meyer28j/level-detector/src/Core/Src/main.c

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
/* Includes ------------------------------------------------------------------*/
#include "main.h"
#include "cmsis_os.h"

I2C_HandleTypeDef hi2c1;

TIM_HandleTypeDef htim3;
DMA_HandleTypeDef hdma_tim3_ch1_trig;

UART_HandleTypeDef huart2;

/* Definitions for Init */
osThreadId_t InitHandle;
const osThreadAttr_t Init_attributes = {
  .name = "Init",
  .stack_size = 512 * 4,
  .priority = (osPriority_t) osPriorityHigh,
};
/* Definitions for LEDUpdate */
osThreadId_t LEDUpdateHandle;
const osThreadAttr_t LEDUpdate_attributes = {
  .name = "LEDUpdate",
  .stack_size = 512 * 4,
  .priority = (osPriority_t) osPriorityAboveNormal,
};
/* USER CODE BEGIN PV */

uint8_t RXChar; // input character from HAL_UART
HAL_StatusTypeDef status; // HAL_OK, HAL_ERROR, HAL_BUSY, HAL_TIMEOUT

/* USER CODE END PV */

void SystemClock_Config(void);
static void MX_GPIO_Init(void);
static void MX_DMA_Init(void);
static void MX_USART2_UART_Init(void);
static void MX_I2C1_Init(void);
static void MX_TIM3_Init(void);
void StartInit(void *argument);
void StartLEDUpdate(void *argument);

/* USER CODE BEGIN 0 */

/**
  * @brief process a receiving character from USART
  *        The goal is to keep the function as fast as possible
  *        and to delegate the slow tasks like transmission
  *        to the main to increase the availability of the
  *        function to serve the next interrupt
  * @param huart:  handler to USART2 ( the only used one - no need to check)
  * @retval None
  */
void HAL_UART_RxCpltCallback(UART_HandleTypeDef *huart)
{
        // process input string
        HandleInput(huart, RXChar);

        // wait until status is ok
        while((HAL_UART_GetState(huart)&HAL_UART_STATE_BUSY_RX)
                        == HAL_UART_STATE_BUSY_RX);
        //Listen for the interrupt and buffer one character at a time.
        status = HAL_UART_Receive_IT(huart, &RXChar, 1);
        if (status != HAL_OK)
        {
                Error_Handler();
        }

        return;
}

void HAL_GPIO_EXTI_Callback(uint16_t GPIO_Pin)
{
	return;
	/*
	if (GPIO_Pin == GPIO_PIN_9)
	{
    	BaseType_t xHigherPriorityTaskWoken = pdFALSE;
    	vTaskNotifyGiveFromISR(IMUDataFetchHandle, &xHigherPriorityTaskWoken);
    	portYIELD_FROM_ISR(xHigherPriorityTaskWoken);
	}
	*/
}

/* USER CODE END 0 */

/**
  * @brief  The application entry point.
  * @retval int
  */
int main(void)
{

  /* MCU Configuration--------------------------------------------------------*/

  /* Reset of all peripherals, Initializes the Flash interface and the Systick. */
  HAL_Init();

  /* Configure the system clock */
  SystemClock_Config();

  /* Initialize all configured peripherals */
  MX_GPIO_Init();
  MX_DMA_Init();
  MX_USART2_UART_Init();
  MX_I2C1_Init();
  MX_TIM3_Init();
  /* Init scheduler */
  osKernelInitialize();

  /* USER CODE BEGIN RTOS_MUTEX */
  /* add mutexes, ... */
  /* USER CODE END RTOS_MUTEX */

  /* USER CODE BEGIN RTOS_SEMAPHORES */
  /* add semaphores, ... */
  /* USER CODE END RTOS_SEMAPHORES */

  /* USER CODE BEGIN RTOS_TIMERS */
  /* start timers, add new ones, ... */
  /* USER CODE END RTOS_TIMERS */

  /* USER CODE BEGIN RTOS_QUEUES */
  /* add queues, ... */
  /* USER CODE END RTOS_QUEUES */

  /* Create the thread(s) */
  /* creation of Init */
  InitHandle = osThreadNew(StartInit, NULL, &Init_attributes);

  /* creation of LEDUpdate */
  LEDUpdateHandle = osThreadNew(StartLEDUpdate, NULL, &LEDUpdate_attributes);

  /* USER CODE BEGIN RTOS_THREADS */
  /* add threads, ... */
  /* USER CODE END RTOS_THREADS */

  /* USER CODE BEGIN RTOS_EVENTS */
  /* add events, ... */
  /* USER CODE END RTOS_EVENTS */

  /* Start scheduler */
  osKernelStart();

  /* We should never get here as control is now taken by the scheduler */

  /* Infinite loop */
  /* USER CODE BEGIN WHILE */
  while (1)
  {
    /* USER CODE END WHILE */

    /* USER CODE BEGIN 3 */
  }
  /* USER CODE END 3 */
}

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
/* USER CODE BEGIN Header_StartInit */
/**
* @brief Function implementing the Init thread.
* @param argument: Not used
* @retval None
*/
/* USER CODE END Header_StartInit */
void StartInit(void *argument)
{
  /* USER CODE BEGIN 5 */

	while (accel_init() != HAL_OK) {} // configure I2C LSM303DLHC peripheral

	CLIInit(&huart2); // initialize CLI
	HAL_UART_Receive_IT(&huart2, &RXChar, 1); // start receiving CLI input
	WS2812B_init(); // start data flow to LED matrix

	// set all LEDs to blue as indicator for init complete
	// should be immediately overwritten once IMU data is read and written to LEDs
	for (int i = 0; i < NUM_LEDS; i++)
	{
	  WS2812B_set_pixel_color(i, 0, 0, 8);
	}
	WS2812B_update();

	// suspend task after executing
	vTaskSuspend(NULL);

  /* USER CODE END 5 */
}

/* USER CODE BEGIN Header_StartLEDUpdate */
/**
* @brief Function implementing the LEDUpdate thread.
* @param argument: Not used
* @retval None
*/
/* USER CODE END Header_StartLEDUpdate */
void StartLEDUpdate(void *argument)
{
  /* USER CODE BEGIN StartLEDUpdate */

  const TickType_t xFrequency = pdMS_TO_TICKS(300);
  TickType_t xLastWakeTime;

  xLastWakeTime = xTaskGetTickCount();

  /* Infinite loop */
  for(;;)
  	{
	  vTaskDelayUntil(&xLastWakeTime, xFrequency);

	  // fetch accelerometer data
	  AccelData accel_values = read_accelerometer_data();

	  // handle console refresh
	  RefreshStatus(&huart2, accel_values);

	  // update led dispay
	  WS2812B_point(accel_values);
	  WS2812B_update();
	}
  /* USER CODE END StartLEDUpdate */
}

/**
  * @brief  Period elapsed callback in non blocking mode
  * @note   This function is called  when TIM4 interrupt took place, inside
  * HAL_TIM_IRQHandler(). It makes a direct call to HAL_IncTick() to increment
  * a global variable "uwTick" used as application time base.
  * @param  htim : TIM handle
  * @retval None
  */
void HAL_TIM_PeriodElapsedCallback(TIM_HandleTypeDef *htim)
{
  if (htim->Instance == TIM4) {
    HAL_IncTick();
  }
}

/**
  * @brief  This function is executed in case of error occurrence.
  * @retval None
  */
void Error_Handler(void)
{
  /* USER CODE BEGIN Error_Handler_Debug */
  /* User can add his own implementation to report the HAL error return state */
  __disable_irq();
  while (1)
  {
  }
  /* USER CODE END Error_Handler_Debug */
}

#ifdef  USE_FULL_ASSERT
/**
  * @brief  Reports the name of the source file and the source line number
  *         where the assert_param error has occurred.
  * @param  file: pointer to the source file name
  * @param  line: assert_param error line source number
  * @retval None
  */
void assert_failed(uint8_t *file, uint32_t line)
{
  /* USER CODE BEGIN 6 */
  /* User can add his own implementation to report the file name and line number,
     ex: printf("Wrong parameters value: file %s on line %d\r\n", file, line) */
  /* USER CODE END 6 */
}
#endif /* USE_FULL_ASSERT */
