meyer28j/level-detector/src/Core/Inc/i2c.h

/**
 * @file i2c.h
 * @author Jacob Meyer
 * @brief This file contains the implementation of I2C functions for the LSM303DLHC.
 *
 * This module retrieves the X/Y/Z readings from the linear accelerometer
 * and returns them in the form of a struct "AccelData." It also provides a boolean
 * check for whether the data can be interpreted as the device being in a level
 * orientation within a specified tolerance.
 */

#ifndef INC_I2C_H_
#define INC_I2C_H_

#include "stm32f1xx_hal.h"

#define LSM303DLHC_ADDRESS_ACCEL (0x19 << 1) // subaddress for linear accelerometer
#define LSM303DLHC_OUT_X_L_A (0x2C) // register address for X-axis low byte
#define LSM303DLHC_DATA_MAX_BYTES (6) // 2 bytes of data per axis (X_L, X_H, Y_L, Y_H, Z_L, Z_H)
#define LSM303DLHC_FLAG_AUTO_INCREMENT (0x80) // OR with subaddress to signal that the data register should auto-increment
#define LSM303DLHC_CTRL_REG1_A (0x20) // data rate selection, low-power mode, and X/Y/Z axis-enable
#define LSM303DLHC_CTRL_REG3_A (0x22) // interrupt enable

/**
 * @brief The minimum threshold of axes readings before accepting that the device is level.
 *
 * It is used in the is_level function to return a boolean value (0 or 1) accordingly.
 */
static const int16_t LEVEL_THRESHOLD = 500;

/**
 * @ brief The maximum threshold of axes readings before indicating how near level the device is.
 *
 * It is used in the is_near_level function to return a value within a
 * short range and used to modulate the brightness of the center pixels.
 */
static const uint16_t LEVEL_THRESHOLD_OUTER = 2000;

static const uint16_t LEVEL_THRESHOLD_STEPS = 10;

/**
 * @brief Specifies an approximation of the maximum meaningful value of gravity read by the IMU at rest.
 *
 * It is used as a "maximum range" value that can be expected from a single axis
 * of data while the IMU is at rest. This value may be exceeded while the device
 * is in motion; the excess value will be truncated to MAX_AT_REST because it does
 * not provide any meaningful information for the device's use case.
 */
static const int16_t MAX_AT_REST = 10000;

static const uint16_t MAX_TIMEOUT = 5000;

/**
 * @brief A global variable created generated by the .ioc file for handling the I2C peripheral.
 */
extern I2C_HandleTypeDef hi2c1;


/**
 * @struct AccelData
 * @brief Structure to hold accelerometer data.
 *
 * Contains the raw X, Y, and Z axis readings.
 */
typedef struct
{
	int16_t x;
	int16_t y;
	int16_t z;
} AccelData;

/**
 * @brief Initializes the LSM303DLHC linear accelerator control register.
 *
 * It sets the data rate to 100Hz, disables low-power mode, and enables each of
 * the X/Y/Z axes for data retrieval.
 *
 * @param none
 * @return HAL_OK if initialization is successful, HAL_ERROR otherwise.
 */
HAL_StatusTypeDef accel_init();

/**
 * @brief Reads and returns the data in all 3 accelerometer axes.
 *
 * It takes advantage of the LSM303DLHC register auto-increment feature to
 * read the 6 bytes of data (X_High, X_Low, Y_High, etc) in a single I2C frame.
 *
 * @param none
 * @return AccelData struct populated with raw X, Y, and Z axis readings.
 */
AccelData read_accelerometer_data();

/**
 * @brief Checks if both the X and Y axis data are within the level tolerance.
 *
 * @param[in] accel_values is the raw X/Y/Z accelerometer data.
 * @return 1 if within tolerance, 0 otherwise.
 */
uint8_t is_level(AccelData accel_values);

/**
 * @brief Compares the combined magnitude of the X and Y data with multiples of the level threshold steps.
 *
 * @param[in] accel_values is the raw X/Y/Z accelerometer data.
 * @return a value in a short range indicating how near level the device is, 0 otherwise
 */
int8_t is_near_level(AccelData accel_values);

#endif /* INC_I2C_H_ */
