meyer28j/level-detector/src/Core/Src/i2c.c

/*
 * i2c.c
 *
 *  Created on: Mar 27, 2025
 *      Author: jacob
 */

#include "i2c.h"

HAL_StatusTypeDef accel_init()
{
	uint8_t ctrl_reg1_a_config = 0b01010111; // ODR = 100Hz, LPen = 0, Zen = 1, Yen = 1, Xen = 1
	uint8_t ctrl_reg3_a_config = 0b00010000; // I1_DRYD1 = 1 (enable)

	HAL_StatusTypeDef status = HAL_ERROR;

	status = HAL_I2C_Mem_Write(&hi2c1, LSM303DLHC_ADDRESS_ACCEL, LSM303DLHC_CTRL_REG1_A, 1,
			&ctrl_reg1_a_config, 1, MAX_TIMEOUT);
	if (status != HAL_OK)
	{
		return status;
	}

	status = HAL_I2C_Mem_Write(&hi2c1, LSM303DLHC_ADDRESS_ACCEL, LSM303DLHC_CTRL_REG3_A, 1,
			&ctrl_reg3_a_config, 1, MAX_TIMEOUT);

	return status;
}

AccelData read_accelerometer_data()
{
	HAL_StatusTypeDef return_status;
	uint8_t raw_data[LSM303DLHC_DATA_MAX_BYTES]; // data returned in 2 bytes
	AccelData accel_values;

	return_status = HAL_I2C_Mem_Read(&hi2c1, LSM303DLHC_ADDRESS_ACCEL, (LSM303DLHC_OUT_X_L_A | LSM303DLHC_FLAG_AUTO_INCREMENT),
			1, raw_data, LSM303DLHC_DATA_MAX_BYTES, MAX_TIMEOUT);
	if (return_status != HAL_OK)
	{
		accel_values.x = -1;
		accel_values.y = -1;
		accel_values.z = -1;
		return accel_values;
	}
	else
	{
		accel_values.z = (int16_t)(raw_data[0] | (raw_data[1] << 8));
		accel_values.y = (int16_t)(raw_data[2] | (raw_data[3] << 8));
		accel_values.x = (int16_t)(raw_data[4] | (raw_data[5] << 8));
	}

	return accel_values;
}

uint8_t is_level(AccelData accel_values)
{
	if (accel_values.y < LEVEL_THRESHOLD && accel_values.y > -LEVEL_THRESHOLD &&
			accel_values.x < LEVEL_THRESHOLD && accel_values.x > -LEVEL_THRESHOLD)
	{
		return 1;
	}
	else
	{
		return 0;
	}
}

int8_t is_near_level(AccelData accel_values)
{
	uint16_t abs_x = accel_values.x >= 0 ? accel_values.x : -accel_values.x;
	uint16_t abs_y = accel_values.y >= 0 ? accel_values.y : -accel_values.y;
	uint16_t magnitude = abs_x + abs_y;
	if (magnitude > LEVEL_THRESHOLD_OUTER)
	{
		return 0;
	}
	uint8_t step_size = (LEVEL_THRESHOLD_OUTER - LEVEL_THRESHOLD) / LEVEL_THRESHOLD_STEPS;
	return LEVEL_THRESHOLD_STEPS - (magnitude - LEVEL_THRESHOLD) / step_size;
}
