meyer28j/level-detector/src/Core/Src/ws2812b.c

/*
 * ws2812b.c
 *
 *  Created on: Apr 7, 2025
 *      Author: jacob
 */

#include "ws2812b.h"

uint16_t led_pwm_data[RESET_FRAMES + NUM_LEDS][BITS_PER_TRANSFER] = {0};

void WS2812B_init()
{
	WS2812B_clear();

	WS2812B_update();
}

void WS2812B_update()
{
	HAL_TIM_PWM_Start_DMA(&htim3, TIM_CHANNEL_1, (uint32_t *)led_pwm_data, (uint16_t)((RESET_FRAMES + NUM_LEDS) * BITS_PER_TRANSFER));
	// TODO: Replace delay + stop call with timer callback
	//		 -> DMA is non-blocking
	HAL_Delay(2);
	HAL_TIM_PWM_Stop_DMA(&htim3, TIM_CHANNEL_1);
}

void WS2812B_clear()
{
	for (int i = 0; i < NUM_LEDS; i++)
	{
		// turn off all leds
		WS2812B_set_pixel_color(i, 0, 0, 0);
	}
}

void WS2812B_set_pixel_color(uint16_t led_index, uint8_t g, uint8_t r, uint8_t b)
{
	if (led_index < 0 || led_index >= NUM_LEDS)
	{
		// invalid led_index
		return;
	}
	// set first communicated data as reset code by
	// adjusting led_index to end of prefixed reset frame
	led_index += RESET_FRAMES;

	// extract each high and low bit from the 24-bit data series for each pixel's color
	// data sent in MSB first as [8 bits GREEN][8 bits RED][8 bits BLUE]
	for (int i = 0; i < 8; i++)
	{
		led_pwm_data[led_index][i] = (g & (1 << (7 - i))) ? WS2812B_BIT_1_HIGH : WS2812B_BIT_0_HIGH;
	}
	for (int i = 0; i < 8; i++)
	{
		led_pwm_data[led_index][i + 8] = (r & (1 << (7 - i))) ? WS2812B_BIT_1_HIGH : WS2812B_BIT_0_HIGH;
	}
	for (int i = 0; i < 8; i++)
	{
		led_pwm_data[led_index][i + 16] = (b & (1 << (7 - i))) ? WS2812B_BIT_1_HIGH : WS2812B_BIT_0_HIGH;
	}
}

void WS2812B_set_center_color(uint8_t g, uint8_t r, uint8_t b)
{
	static const uint8_t CENTER_PIXELS[4] = {27, 28, 35, 36};

	for (int i = 0; i < sizeof(CENTER_PIXELS) / sizeof(CENTER_PIXELS[0]); i++)
	{
		WS2812B_set_pixel_color(CENTER_PIXELS[i], g, r, b);
	}

}

void WS2812B_set_edge_colors(AccelData accel_values, uint8_t g, uint8_t r, uint8_t b)
{
	if (abs_impl(accel_values.x) < MAX_AT_REST && abs_impl(accel_values.y) < MAX_AT_REST)
	{
		// all accel values are within legal bounds
		return;
	}

	static const uint8_t EDGE_PIXELS[4][MATRIX_LENGTH] = {
			{56, 57, 58, 59, 60, 61, 62, 63},
			{7, 8, 23, 24, 39, 40, 55, 56},
			{0, 1, 2, 3, 4, 5, 6, 7},
			{0, 15, 16, 31, 32, 47, 48, 63}
	};

	uint8_t edge_tb = -1; // top/bottom edge
	uint8_t edge_lr = -1; // left/right edge
	if (accel_values.x < -MAX_AT_REST)
	{
		edge_tb = 2;
	}
	else if (accel_values.x > MAX_AT_REST)
	{
		edge_tb = 0;
	}
	if (accel_values.y < -MAX_AT_REST)
	{
		edge_lr = 3;
	}
	else if (accel_values.y > MAX_AT_REST)
	{
		edge_lr = 1;
	}

	if (edge_tb != -1)
	{
		for (int i = 0; i < MATRIX_LENGTH; i++)
		{
			WS2812B_set_pixel_color(EDGE_PIXELS[edge_tb][i], g, r, b);
		}
	}
	if (edge_lr != -1)
	{
		for (int i = 0; i < MATRIX_LENGTH; i++)
		{
			WS2812B_set_pixel_color(EDGE_PIXELS[edge_lr][i], g, r, b);
		}
	}
}

void WS2812B_point(AccelData accel_values)
{
	WS2812B_clear();

	// if level, display center 4 LEDs as green; return
	if (is_level(accel_values))
	{
		WS2812B_set_center_color(32, 0, 0);
		return;
	}

	uint8_t is_near_level_step = is_near_level(accel_values);
	if (is_near_level_step != 0)
	{
		// display center 4 LEDs as green, modulated brighter the closer to level the device is
		WS2812B_set_center_color(is_near_level_step * 2, 0, 0);
	}
	else
	{
		// display center 4 LEDs as blue for clearer "pointer" indication
		WS2812B_set_center_color(0, 0, 16);
	}

	// if any axis is outside the max range,
	// display the corresponding edge as red; return
	if (abs_impl(accel_values.x) > MAX_AT_REST || abs_impl(accel_values.y) > MAX_AT_REST)
	{
		WS2812B_set_edge_colors(accel_values, 0, 16, 0);
		return;
	}

	// maximum number of steps from one side of the matrix to the other
	static const uint8_t NUM_STEPS = MATRIX_LENGTH - 1;
	// integer size of each step
	static const uint16_t STEP_SIZE = MAX_AT_REST * 2 / MATRIX_LENGTH;

	// X-AXIS: along breadboard long-side: decides COLUMN of pixel position
	// Y-AXIS: along breadboard short-side : decides ROW of pixel position

	// define line "start" as one of 4 center pixels
	int8_t x0_scaled = accel_values.x < 0 ? NUM_STEPS / 2 : NUM_STEPS / 2 + 1;
	int8_t y0_scaled = accel_values.y < 0 ? NUM_STEPS / 2 : NUM_STEPS / 2 + 1;

	// define line "end" by truncating the axis data to one of 8 positions in the range [0, 7]
	uint8_t x1_scaled = 0;
	uint8_t y1_scaled = 0;
	x1_scaled = accel_values.x / STEP_SIZE == 0 ? x0_scaled : (uint8_t)(accel_values.x / STEP_SIZE + MATRIX_LENGTH / 2);
	y1_scaled = accel_values.y / STEP_SIZE == 0 ? y0_scaled : (uint8_t)(accel_values.y / STEP_SIZE + MATRIX_LENGTH / 2);

	bresenham_line_serpentine(x0_scaled, y0_scaled, x1_scaled, y1_scaled);

	return;
}

void bresenham_line_serpentine(uint8_t row0, uint8_t col0, uint8_t row1, uint8_t col1)
{
	int16_t dx = abs_impl(col1 - col0);
	int16_t dy = abs_impl(row1 - row0);
	int16_t sx = (col0 < col1) ? 1 : -1;
	int16_t sy = (row0 < row1) ? 1 : -1;
	int16_t err = dx - dy;

	while(1)
	{
		WS2812B_set_pixel_color(row_col_to_pixel(row0, col0), 0, 8, 0);

		if (row0 == row1 && col0 == col1) break;

		int16_t e2 = 2 * err;
		if (e2 > -dy)
		{
			err -= dy;
			col0 += sx;
		}
		if (e2 < dx)
		{
			err += dx;
			row0 += sy;
		}
	}
}

uint16_t row_col_to_pixel(uint8_t row, uint8_t col)
{
	// LEDs cascade serpentine, so even rows must
	// calculate column position from right-to-left
	if (row % 2 == 0)
	{
		return row * 8 + col;
	}
	else
	{
		return row * 8 + (7 - col);
	}
}

int16_t abs_impl(int16_t val)
{
	return val >= 0 ? val : -val;
}
