meyer28j/level-detector/(commit log)

2026-05-22 Add uart and timer configuration and functions from previous labs
2026-05-22 Add i2c library with implemented accelerometer read function
2026-05-22 Add i2c peripheral init function
2026-05-22 Fix i2c functions to use correctly shifted address
    [i2c.c, i2c.h, level-detector.ioc, main.c, usart_cli.c, usart_cli.h]
2026-05-22 Add x and y values to cli print
2026-05-22 Add LED toggling based on near-level
2026-05-22 Add doxygen blocks to i2c header
2026-05-22 Add uart doxygen comments
2026-05-22 Add doxygen comments for timer module
2026-05-22 Update cli to print build info
2026-05-22 Fix extra sign extension on negative IMU values
    [i2c.c, i2c.h, usart_cli.c]
2026-05-22 Configure TIM3 for PWM DMA of LED matrix values
2026-05-22 Fix #define name for i2c header
    [i2c.h]
2026-05-22 Add .c and .h template for ws2812b led matrix
2026-05-22 Initialize DMA for communicating with LED matrix; add test code to drive it
2026-05-22 Add a MAX_AT_REST const value to the i2c library
2026-05-22 Add a template for an LED matrix point function
2026-05-22 Update main driver test code
2026-05-22 Add abs implementation to avoid loading entire stdlib
    [ws2812b.c, ws2812b.h]
2026-05-22 Reduce transmission end-of-frame signal time
2026-05-22 Change refresh timer to set a flag caught by main to call each update function
2026-05-22 Update led_pwm_data type to match PWM_DMA instead of converting during call
2026-05-22 Update cli refresh to use passed in accelerometer data
2026-05-22 Re-add pointer cast to PWM_DMA arg led_pwm_data
2026-05-22 Add interrupt enable for data ready in IMU
2026-05-22 Add interrupt function and handling for imu data ready; currently disabled
2026-05-22 Change interrupt line from PA1 to PA9 to avoid peripheral collisions
    [level-detector.ioc, main.c]
2026-05-22 Add waiting flag to refresh timer so it waits for point task to finish
2026-05-22 More interrupt auto-generated config code
2026-05-22 Update point function to follow serpentine updating of LEDs
2026-05-22 Move max i2c timeout to .h file
2026-05-22 Replace tim2 hardware interrupt with rtos task delay
    [level-detector.ioc, main.c]
2026-05-22 Fix stray 1st led by prepending reset signal to led_pwm_data
    [ws2812b.c, ws2812b.h]
2026-05-22 Zero-initialize led_pwm_data and fix incorrect scaled data type
    [ws2812b.c]
2026-05-22 Modify bresenham function; fix ternary statements
    [ws2812b.c, ws2812b.h]
2026-05-22 Fix line row start position
    [ws2812b.c]
2026-05-22 Remove on-board LED level indication - obsolete
2026-05-22 Fix led matrix display line begin position with small accel values
    [ws2812b.c, ws2812b.h]
2026-05-22 Add function to set color of center 4 pixels in LED matrix
2026-05-22 Fix edge condition check for set_pixel_color function
    [ws2812b.c]
2026-05-22 Update i2c header to include is_near_level function; fixup comments
    [i2c.h]
2026-05-22 Fix bug with near-level detection
    [i2c.c]
